EverettPul13/Macropact_v2/presentation/Macro Pad Marketing Flyer (5).pdf

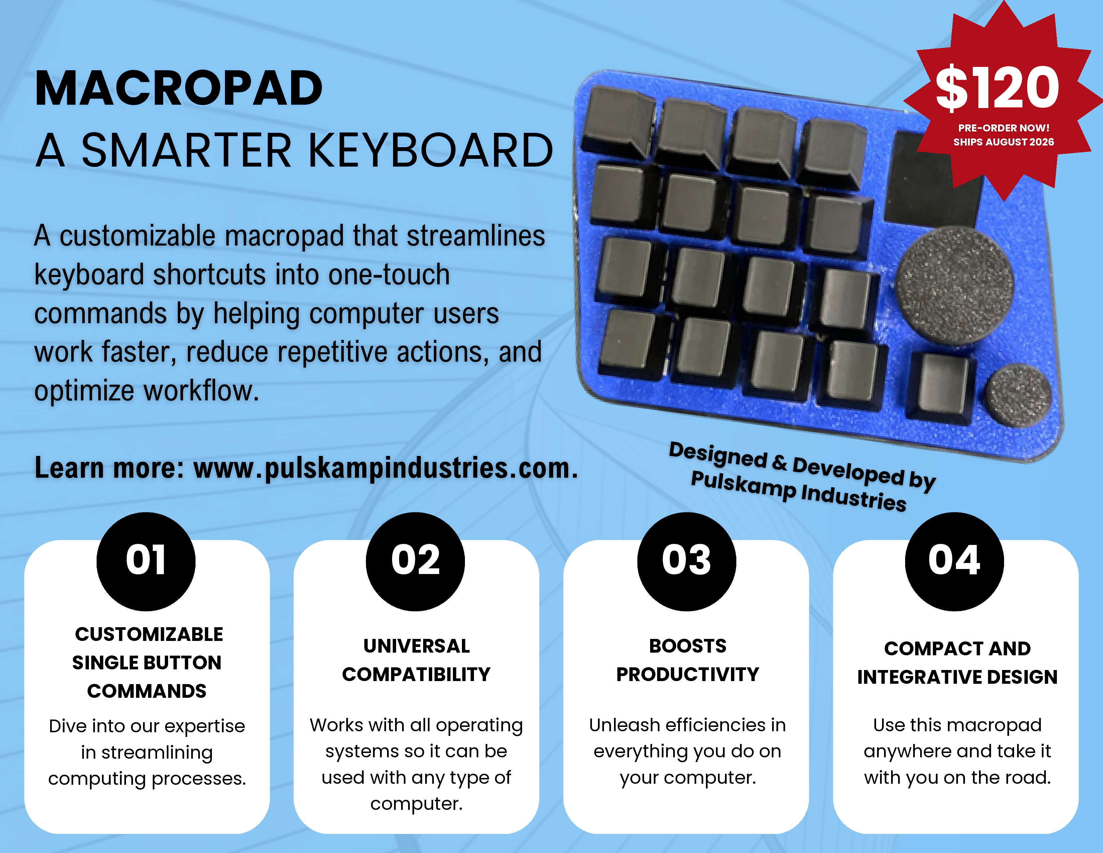
[picture p13: page 1]
