EverettPul13/Macropact_v2/Code/L0.bmp

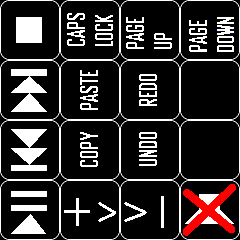
Code/L0.bmp
