EverettPul13/Macropact_v2/Code/L1.bmp

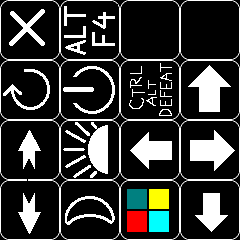
Code/L1.bmp
