EverettPul13/Macropact_v2/stl/GlowInsert.stl

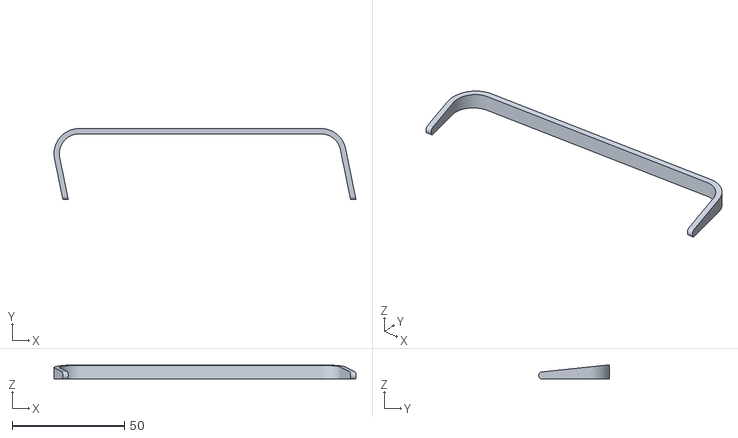
[picture p17: CAD file, 2026-05-21]
stl/GlowInsert.stl
134.8 x 31.6 x 6.40
