EverettPul13/Macropact_v2/stl/Bottom.stl

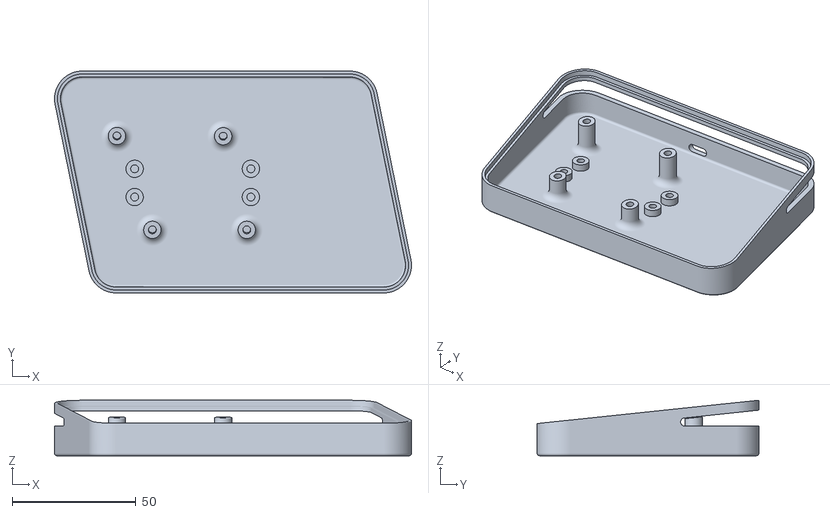
[picture p18: CAD file, 2026-05-21]
stl/Bottom.stl
144.1 x 89.5 x 22.4
