EverettPul13/Macropact_v2/stl/TopPlate.stl

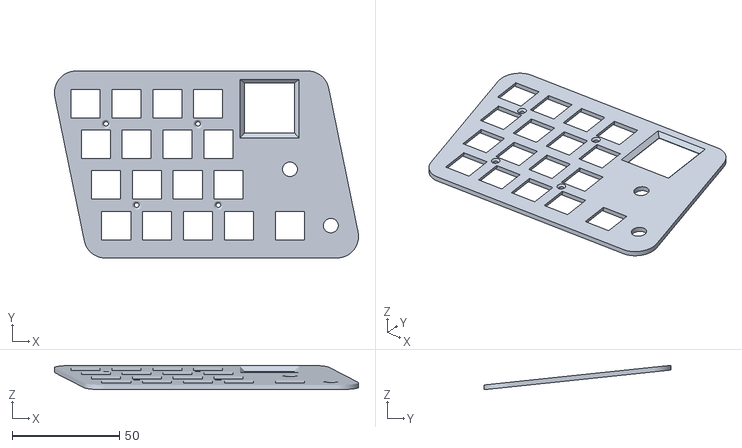
[picture p19: CAD file, 2026-05-21]
stl/TopPlate.stl
141.7 x 87.2 x 11.4
